microresearch/RAVEN/raven_kicad/raven_kicad.kicad_pcb

## KiCad design raven_kicad/raven_kicad.kicad_pcb (2021-03-04)

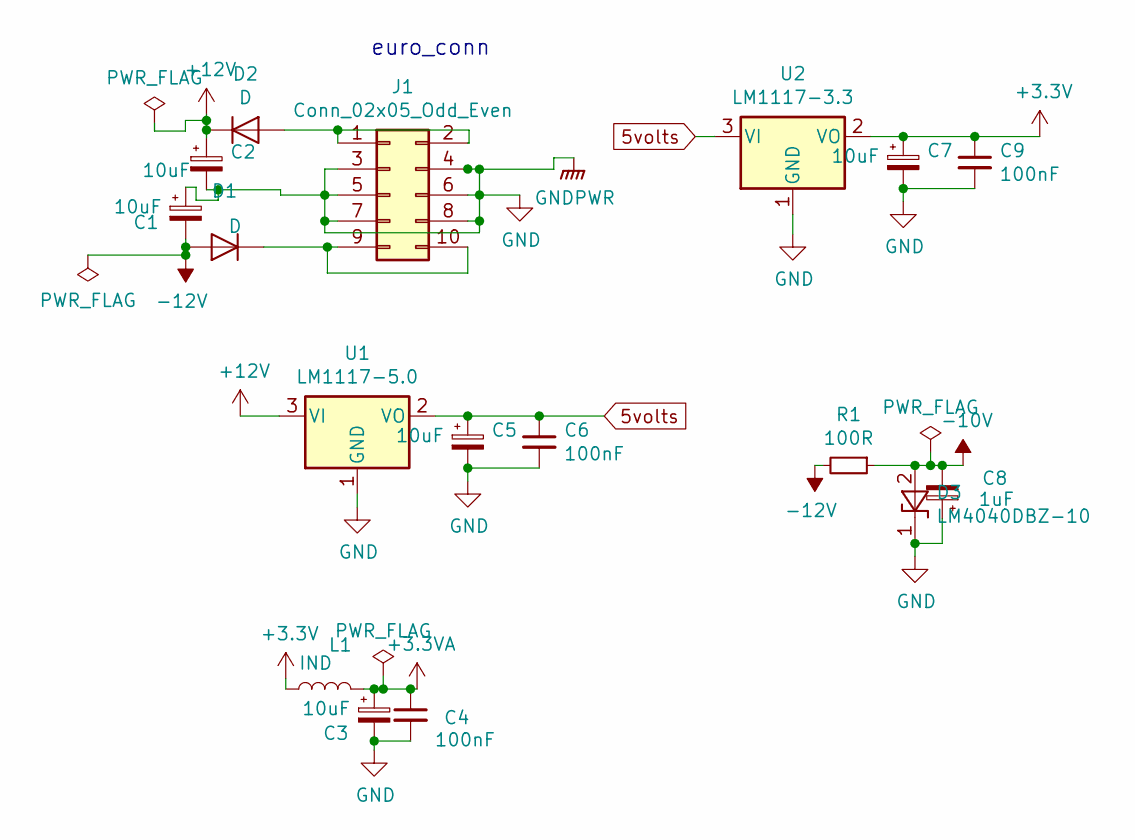
[picture p1: schematic power.sch, SEGMENTS]

Parts:
C1, C2, C3, C5, C7: 10uF; SMD-1206_Pol
C4, C6, C9: 100nF; C_0805
C8: 1uF; SMD-1206_Pol
D1, D2: D; D_SOD-123
D3: LM4040DBZ-10; SOT-23
J1: Conn_02x05_Odd_Even; Pin_Header_Straight_2x05_Pitch2.54mm
L1: IND; L_0603
R1: 100R; R_0805
U1: LM1117-5.0; TO-252-2_Rectifier
U2: LM1117-3.3; TO-252-2_Rectifier

Connections:
5volts: C5.1, C6.1, U1.2 (VO), U2.3 (VI)
+3.3VA: C3.1, C4.1, L1.2; also elsewhere on the board
+3V3: C7.1, C9.1, L1.1, U2.2 (VO); also elsewhere on the board
+12V: C2.1, D2.1 (K), U1.3 (VI); also elsewhere on the board
-10V: C8.2, D3.2 (A), R1.1; also elsewhere on the board
-12V: C1.2, D1.2 (A), R1.2; also elsewhere on the board
GND: C1.1, C2.2, C3.2, C4.2, C5.2, C6.2, C7.2, C8.1, C9.2, D3.1 (K), J1.3, J1.4, J1.5, J1.6, J1.7, J1.8, U1.1 (GND), U2.1 (GND); also elsewhere on the board
unnamed: D1.1 (K), J1.9, J1.10
unnamed: D2.2 (A), J1.1, J1.2

Notes on the sheet:
euro_conn

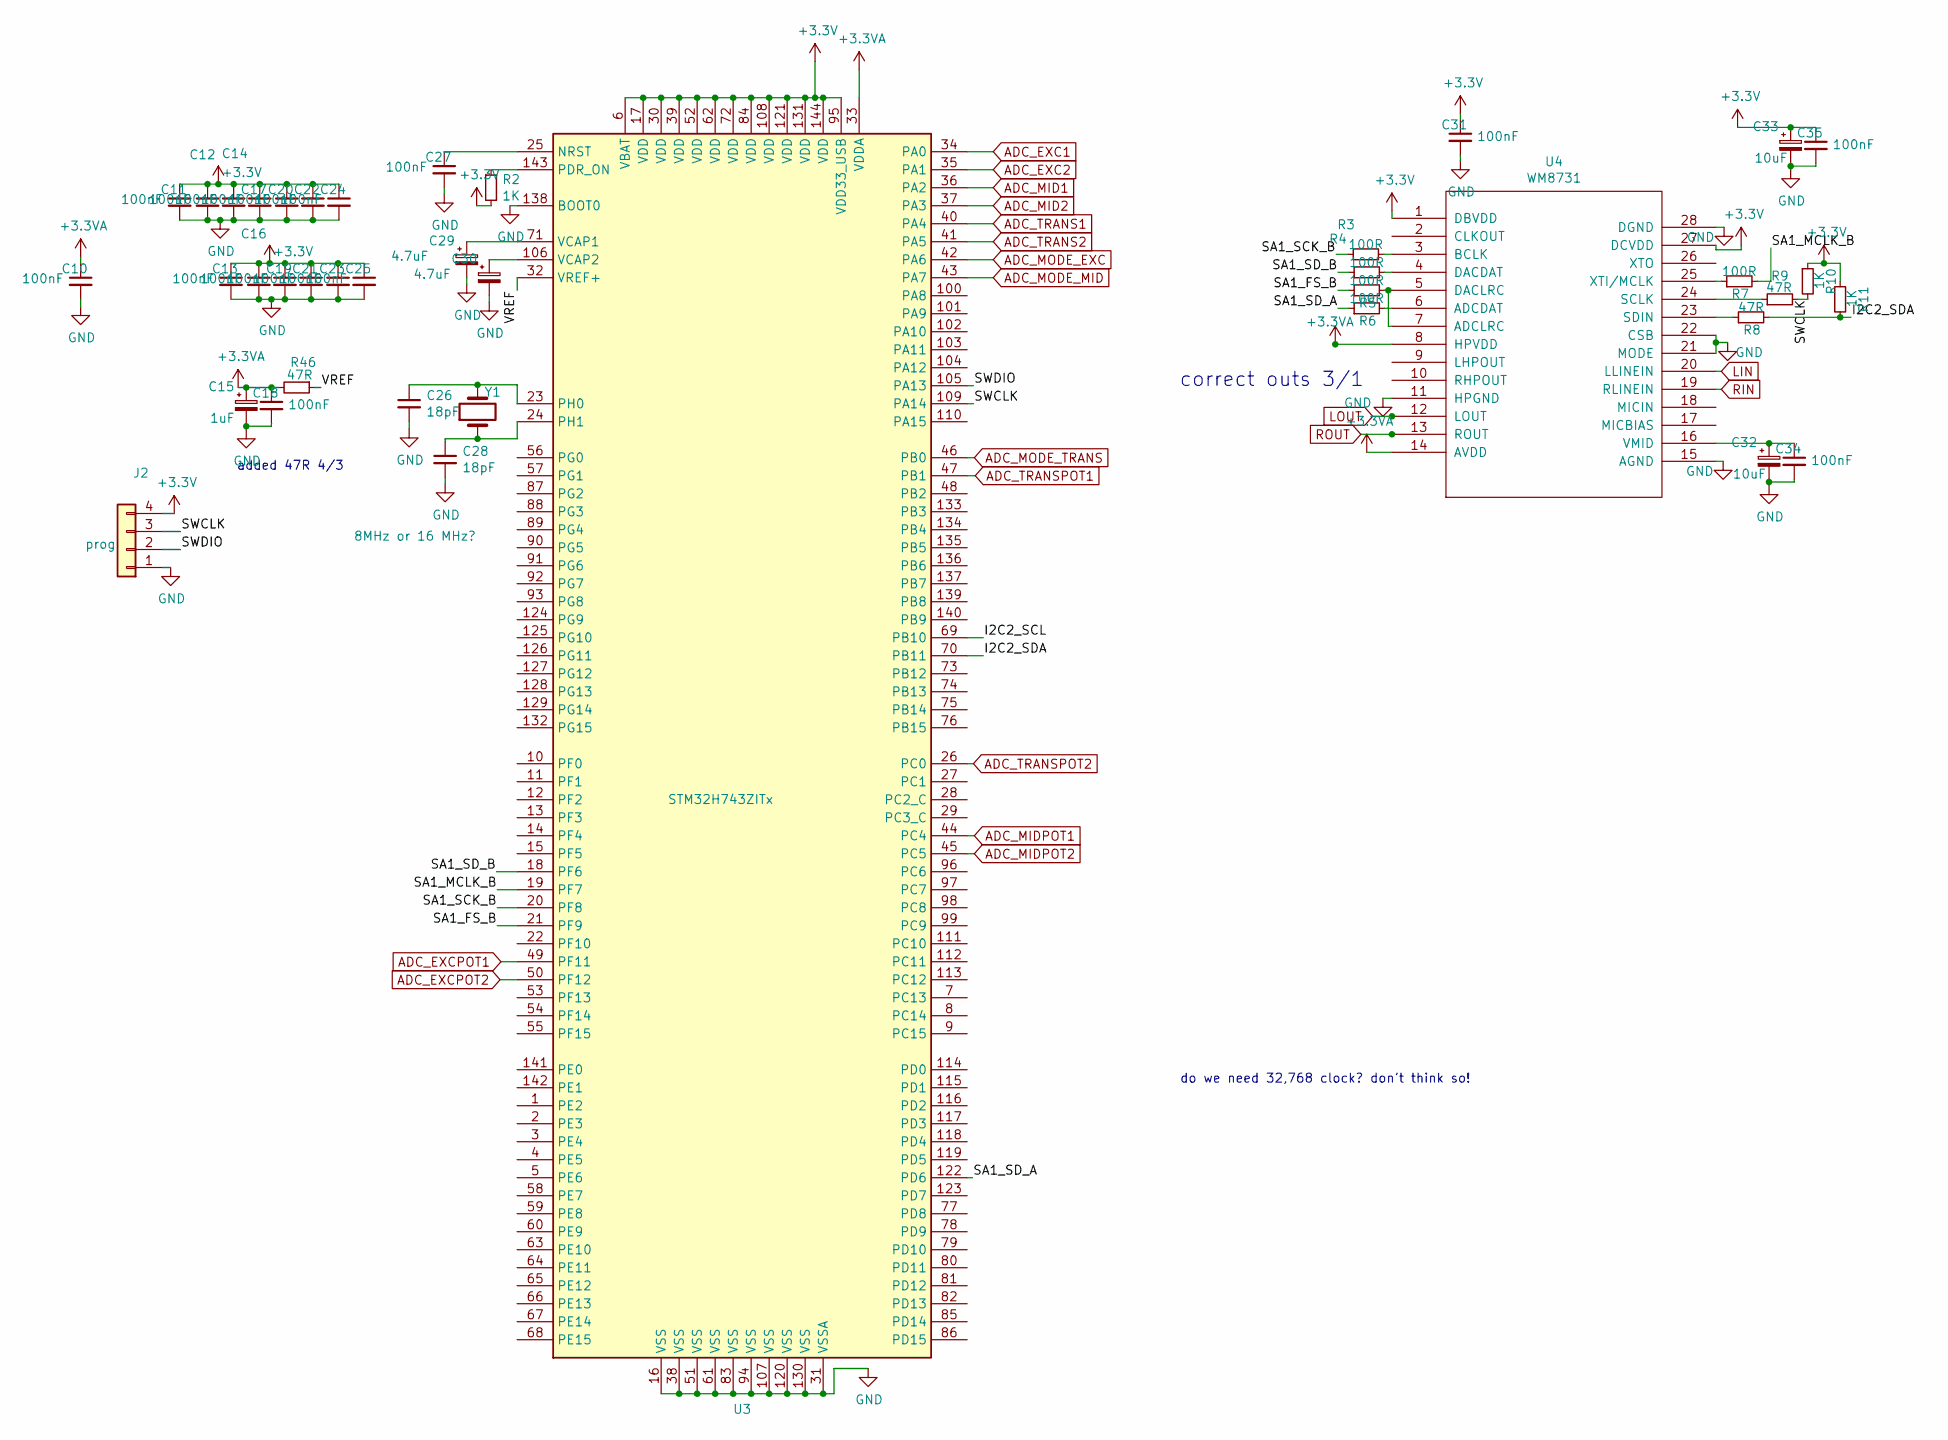
[picture p2: schematic micro.sch]

Parts:
C10, C11, C12, C13, C14, C16, C17, C18, C19, C20, C21, C22, C23, C24, C25, C27, C31, C34, C35: 100nF; C_0805
C15: 1uF; SMD-1206_Pol
C26, C28: 18pF; C_0805
C29, C30: 4.7uF; SMD-1206_Pol
C32, C33: 10uF; SMD-1206_Pol
J2: prog; Pin_Header_Straight_1x04_Pitch2.54mm
R2, R10, R11: 1K; R_0805
R3, R4, R5, R6, R7: 100R; R_0805
R8, R9, R46: 47R; R_0805
U3: STM32H743ZITx; LQFP-144_20x20mm_Pitch0.5mm
U4: WM8731; SSOP-28_5.3x10.2mm_Pitch0.65mm
Y1: 8MHz or 16 MHz?; Crystal_SMD_HC49-SD

Connections:
+3.3VA: C10.1, C15.1, C18.1, R46.2, U3.33 (VDDA), U4.8 (HPVDD), U4.14 (AVDD); also elsewhere on the board
+3V3: C11.1, C12.1, C13.1, C14.1, C16.1, C17.1, C19.1, C20.1, C21.1, C22.1, C23.1, C24.1, C25.1, C31.1, C33.1, C35.1, J2.4, R2.2, R10.1, R11.1, U3.6 (VBAT), U3.17 (VDD), U3.30 (VDD), U3.39 (VDD), U3.52 (VDD), U3.62 (VDD), U3.72 (VDD), U3.84 (VDD), U3.95 (VDD33_USB), U3.108 (VDD), U3.121 (VDD), U3.131 (VDD), U3.144 (VDD), U4.1 (DBVDD), U4.27 (DCVDD); also elsewhere on the board
/micro/I2C2_SDA: R8.2, R11.2, U3.70 (PB11)
/micro/SA1_FS_B: R5.1, U3.21 (PF9)
/micro/SA1_MCLK_B: R7.2, U3.19 (PF7)
/micro/SA1_SCK_B: R3.1, U3.20 (PF8)
/micro/SA1_SD_A: R6.1, U3.122 (PD6)
/micro/SA1_SD_B: R4.1, U3.18 (PF6)
/micro/SWCLK: J2.3, R9.2, R10.2, U3.109 (PA14)
/micro/SWDIO: J2.2, U3.105 (PA13)
/micro/VREF: R46.1, U3.32 (VREF+)
ADC_EXC1: U3.34 (PA0); also elsewhere on the board
ADC_EXC2: U3.35 (PA1); also elsewhere on the board
ADC_EXCPOT1: U3.49 (PF11); also elsewhere on the board
ADC_EXCPOT2: U3.50 (PF12); also elsewhere on the board
ADC_MID1: U3.36 (PA2); also elsewhere on the board
ADC_MID2: U3.37 (PA3); also elsewhere on the board
ADC_MIDPOT1: U3.44 (PC4); also elsewhere on the board
ADC_MIDPOT2: U3.45 (PC5); also elsewhere on the board
ADC_MODE_EXC: U3.42 (PA6); also elsewhere on the board
ADC_MODE_MID: U3.43 (PA7); also elsewhere on the board
ADC_MODE_TRANS: U3.46 (PB0); also elsewhere on the board
ADC_TRANS1: U3.40 (PA4); also elsewhere on the board
ADC_TRANS2: U3.41 (PA5); also elsewhere on the board
ADC_TRANSPOT1: U3.47 (PB1); also elsewhere on the board
ADC_TRANSPOT2: U3.26 (PC0); also elsewhere on the board
GND: C10.2, C11.2, C12.2, C13.2, C14.2, C15.2, C16.2, C17.2, C18.2, C19.2, C20.2, C21.2, C22.2, C23.2, C24.2, C25.2, C26.2, C27.2, C28.2, C29.2, C30.2, C31.2, C32.2, C33.2, C34.2, C35.2, J2.1, U3.16 (VSS), U3.31 (VSSA), U3.38 (VSS), U3.51 (VSS), U3.61 (VSS), U3.83 (VSS), U3.94 (VSS), U3.107 (VSS), U3.120 (VSS), U3.130 (VSS), U3.138 (BOOT0), U4.11 (HPGND), U4.15 (AGND), U4.21 (MODE), U4.22 (CSB), U4.28 (DGND); also elsewhere on the board
LIN: U4.20 (LLINEIN); also elsewhere on the board
LOUT: U4.12 (LOUT); also elsewhere on the board
unnamed: C26.1, U3.23 (PH0), Y1.2
unnamed: C27.1, U3.25 (NRST)
unnamed: C28.1, U3.24 (PH1), Y1.1
unnamed: C29.1, U3.71 (VCAP1)
unnamed: C30.1, U3.106 (VCAP2)
unnamed: C32.1, C34.1, U4.16 (VMID)
unnamed: R2.1, U3.143 (PDR_ON)
unnamed: R3.2, U4.3 (BCLK)
unnamed: R4.2, U4.4 (DACDAT)
unnamed: R5.2, U4.5 (DACLRC), U4.7 (ADCLRC)
unnamed: R6.2, U4.6 (ADCDAT)
unnamed: R7.1, U4.25 (XTI/MCLK)
unnamed: R8.1, U4.23 (SDIN)
unnamed: R9.1, U4.24 (SCLK)
RIN: U4.19 (RLINEIN); also elsewhere on the board
ROUT: U4.13 (ROUT); also elsewhere on the board

Notes on the sheet:
do we need 32,768 clock? don't think so!
correct outs 3/1
added 47R 4/3

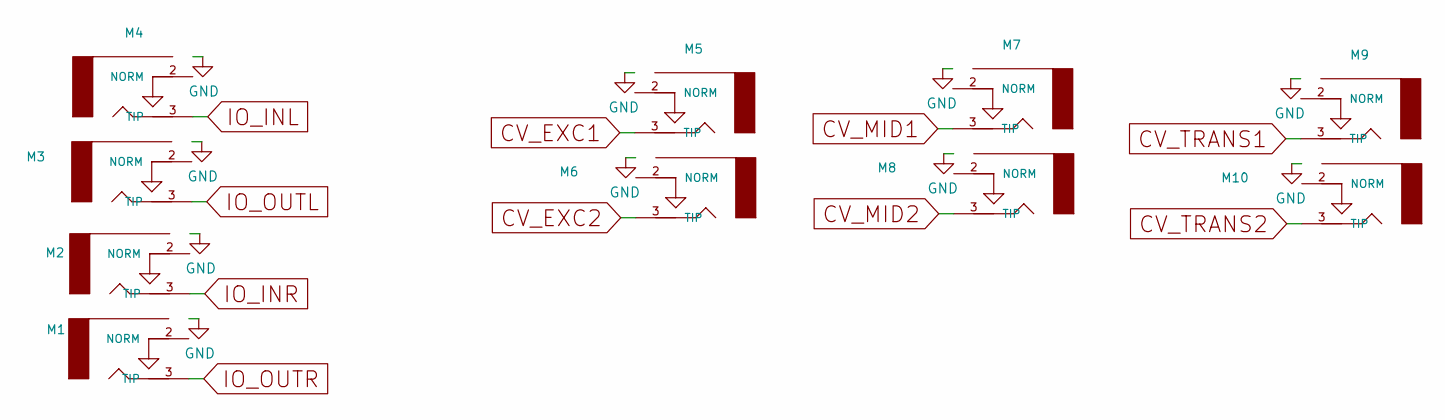
[picture p3: schematic inout.sch, SEGMENTS]

Parts:
M1, M2, M3, M4, M5, M6, M7, M8, M9, M10: AUDIO-JACKERTHENVAR; Jack_3.5mm_QingPu_WQP-PJ398SM_Vertical_CircularHoles

Connections:
CV_EXC1: M5.3 (TIP); also elsewhere on the board
CV_EXC2: M6.3 (TIP); also elsewhere on the board
CV_MID1: M7.3 (TIP); also elsewhere on the board
CV_MID2: M8.3 (TIP); also elsewhere on the board
CV_TRANS1: M9.3 (TIP); also elsewhere on the board
CV_TRANS2: M10.3 (TIP); also elsewhere on the board
GND: M1.1 (RING), M2.1 (RING), M3.1 (RING), M4.1 (RING), M5.1 (RING), M6.1 (RING), M7.1 (RING), M8.1 (RING), M9.1 (RING), M10.1 (RING); also elsewhere on the board
IO_INL: M4.3 (TIP); also elsewhere on the board
IO_INR: M2.3 (TIP); also elsewhere on the board
IO_OUTL: M3.3 (TIP); also elsewhere on the board
IO_OUTR: M1.3 (TIP); also elsewhere on the board

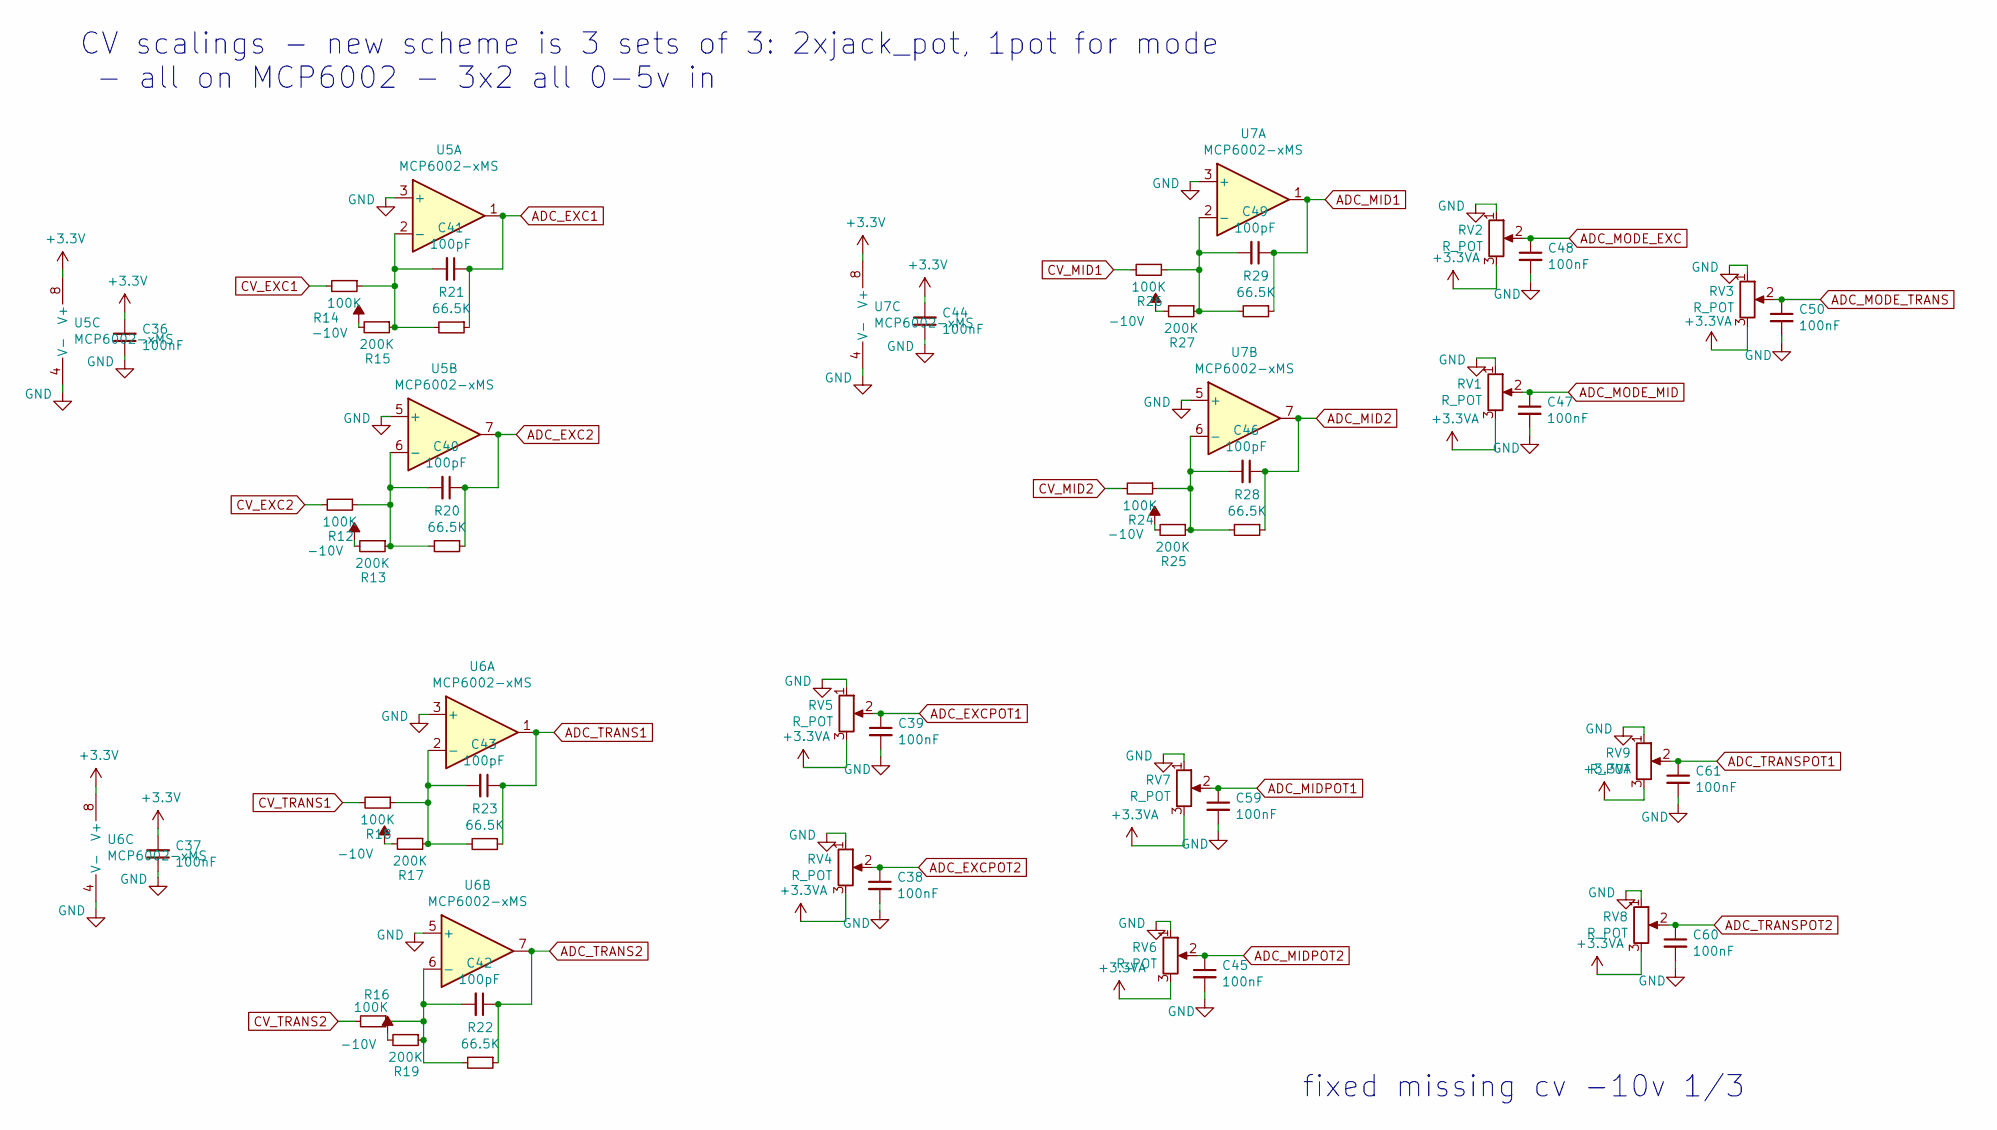
[picture p4: schematic cv.sch]

Parts:
C36, C37, C38, C39, C44, C45, C47, C48, C50, C59, C60, C61: 100nF; C_0805
C40, C41, C42, C43, C46, C49: 100pF; C_0805
R12, R14, R16, R18, R24, R26: 100K; R_0805
R13, R15, R17, R19, R25, R27: 200K; R_0805
R20, R21, R22, R23, R28, R29: 66.5K; R_0805
RV1, RV2, RV3, RV4, RV5, RV6, RV7, RV8, RV9: R_POT; Potentiometer_Alps-RK09
U5, U6, U7: MCP6002-xMS; SOIC-8-N

Connections:
+3.3VA: RV1.3, RV2.3, RV3.3, RV4.3, RV5.3, RV6.3, RV7.3, RV8.3, RV9.3; also elsewhere on the board
+3V3: C36.2, C37.2, C44.2, U5.8 (V+), U6.8 (V+), U7.8 (V+); also elsewhere on the board
-10V: R13.2, R15.2, R17.2, R19.2, R25.2, R27.2; also elsewhere on the board
ADC_EXC1: C41.1, R21.1, U5.1; also elsewhere on the board
ADC_EXC2: C40.1, R20.1, U5.7; also elsewhere on the board
ADC_EXCPOT1: C39.1, RV5.2; also elsewhere on the board
ADC_EXCPOT2: C38.1, RV4.2; also elsewhere on the board
ADC_MID1: C49.1, R29.1, U7.1; also elsewhere on the board
ADC_MID2: C46.1, R28.1, U7.7; also elsewhere on the board
ADC_MIDPOT1: C59.1, RV7.2; also elsewhere on the board
ADC_MIDPOT2: C45.1, RV6.2; also elsewhere on the board
ADC_MODE_EXC: C48.1, RV2.2; also elsewhere on the board
ADC_MODE_MID: C47.1, RV1.2; also elsewhere on the board
ADC_MODE_TRANS: C50.1, RV3.2; also elsewhere on the board
ADC_TRANS1: C43.1, R23.1, U6.1; also elsewhere on the board
ADC_TRANS2: C42.1, R22.1, U6.7; also elsewhere on the board
ADC_TRANSPOT1: C61.1, RV9.2; also elsewhere on the board
ADC_TRANSPOT2: C60.1, RV8.2; also elsewhere on the board
CV_EXC1: R14.2; also elsewhere on the board
CV_EXC2: R12.2; also elsewhere on the board
CV_MID1: R26.2; also elsewhere on the board
CV_MID2: R24.2; also elsewhere on the board
CV_TRANS1: R18.2; also elsewhere on the board
CV_TRANS2: R16.2; also elsewhere on the board
GND: C36.1, C37.1, C38.2, C39.2, C44.1, C45.2, C47.2, C48.2, C50.2, C59.2, C60.2, C61.2, RV1.1, RV2.1, RV3.1, RV4.1, RV5.1, RV6.1, RV7.1, RV8.1, RV9.1, U5.3 (+), U5.4 (V-), U5.5 (+), U6.3 (+), U6.4 (V-), U6.5 (+), U7.3 (+), U7.4 (V-), U7.5 (+); also elsewhere on the board
unnamed: C40.2, R12.1, R13.1, R20.2, U5.6 (-)
unnamed: C41.2, R14.1, R15.1, R21.2, U5.2 (-)
unnamed: C42.2, R16.1, R19.1, R22.2, U6.6 (-)
unnamed: C43.2, R17.1, R18.1, R23.2, U6.2 (-)
unnamed: C46.2, R24.1, R25.1, R28.2, U7.6 (-)
unnamed: C49.2, R26.1, R27.1, R29.2, U7.2 (-)

Notes on the sheet:
CV scalings - new scheme is 3 sets of 3: 2xjack_pot, 1pot for mode - all on MCP6002 - 3x2 all 0-5v in
fixed missing cv -10v 1/3

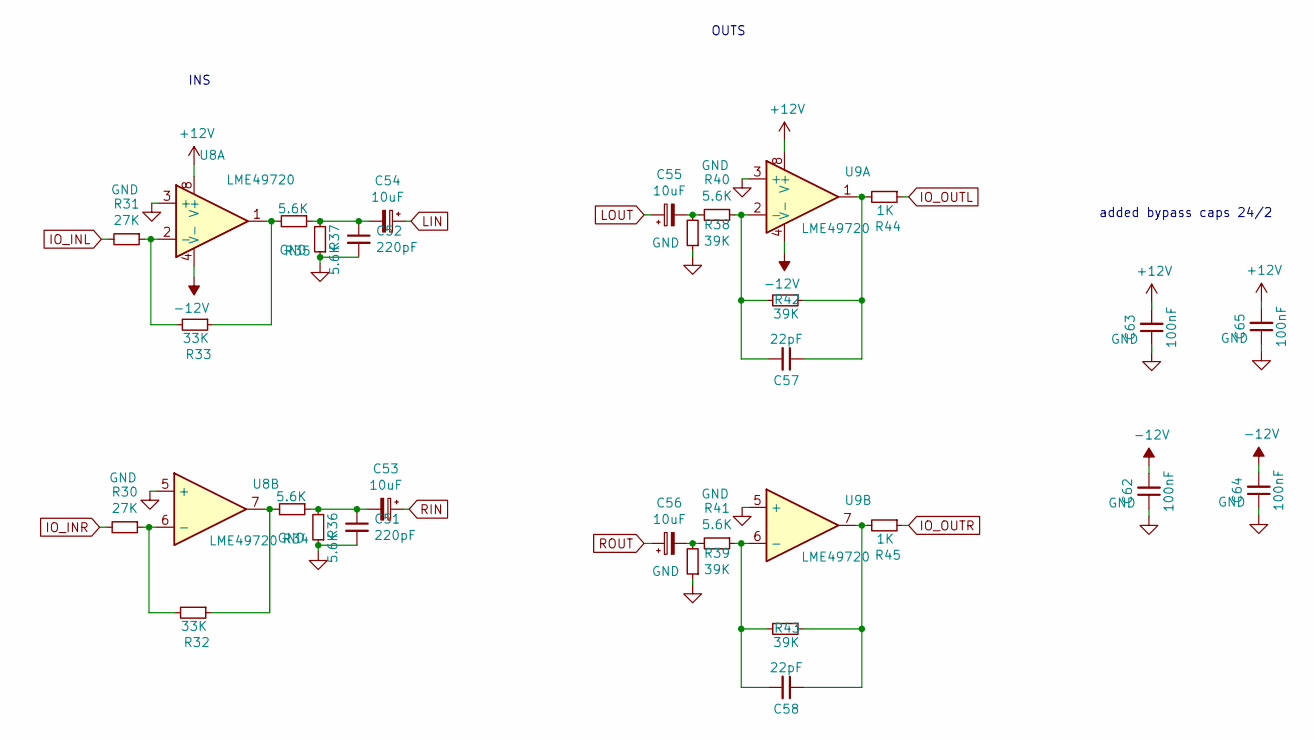
[picture p5: schematic inoutamps.sch]

Parts:
C51, C52: 220pF; C_0805
C53, C54, C55, C56: 10uF; SMD-1206_Pol
C57, C58: 22pF; C_0805
C62, C63, C64, C65: 100nF; C_0805
R30, R31: 27K; R_0805
R32, R33: 33K; R_0805
R34, R35, R36, R37, R40, R41: 5.6K; R_0805
R38, R39, R42, R43: 39K; R_0805
R44, R45: 1K; R_0805
U8, U9: LME49720; SOIC-8-N

Connections:
+12V: C63.2, C65.2, U8.8 (V+), U9.8 (V+); also elsewhere on the board
-12V: C62.2, C64.2, U8.4 (V-), U9.4 (V-); also elsewhere on the board
GND: C51.2, C52.2, C62.1, C63.1, C64.1, C65.1, R36.1, R37.1, R38.1, R39.1, U8.3 (+), U8.5 (+), U9.3 (+), U9.5 (+); also elsewhere on the board
IO_INL: R31.2; also elsewhere on the board
IO_INR: R30.2; also elsewhere on the board
IO_OUTL: R44.1; also elsewhere on the board
IO_OUTR: R45.1; also elsewhere on the board
LIN: C54.1; also elsewhere on the board
LOUT: C55.1; also elsewhere on the board
unnamed: C51.1, C53.2, R34.1, R36.2
unnamed: C52.1, C54.2, R35.1, R37.2
unnamed: C55.2, R38.2, R40.2
unnamed: C56.2, R39.2, R41.2
unnamed: C57.1, R42.1, R44.2, U9.1
unnamed: C57.2, R40.1, R42.2, U9.2 (-)
unnamed: C58.1, R43.1, R45.2, U9.7
unnamed: C58.2, R41.1, R43.2, U9.6 (-)
unnamed: R30.1, R32.2, U8.6 (-)
unnamed: R31.1, R33.2, U8.2 (-)
unnamed: R32.1, R34.2, U8.7
unnamed: R33.1, R35.2, U8.1
RIN: C53.1; also elsewhere on the board
ROUT: C56.1; also elsewhere on the board

Notes on the sheet:
INS
OUTS
added bypass caps 24/2

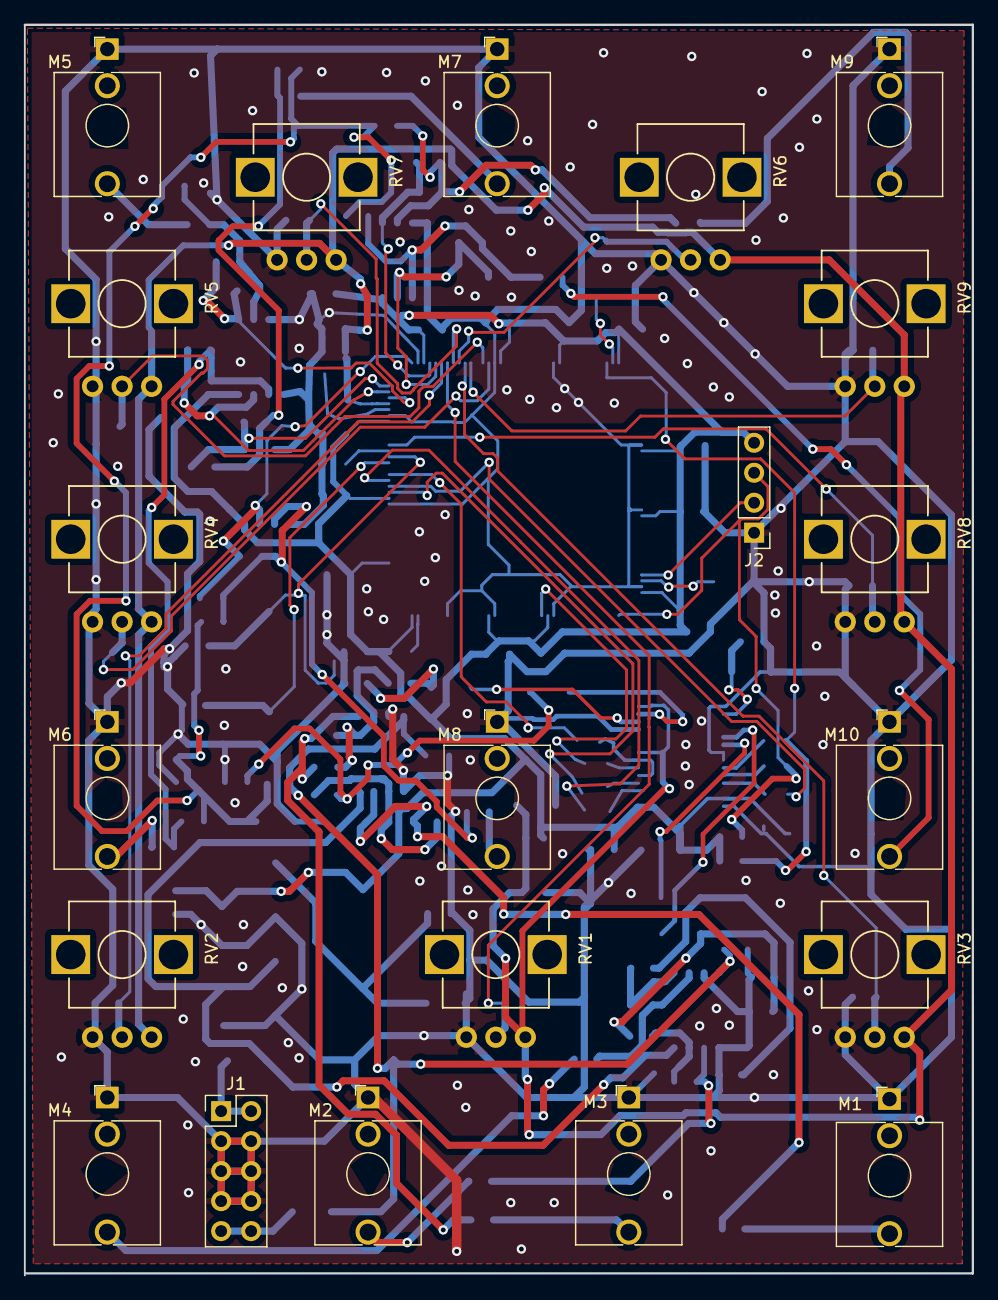
[picture p6: board raven_kicad.kicad_pcb from above]

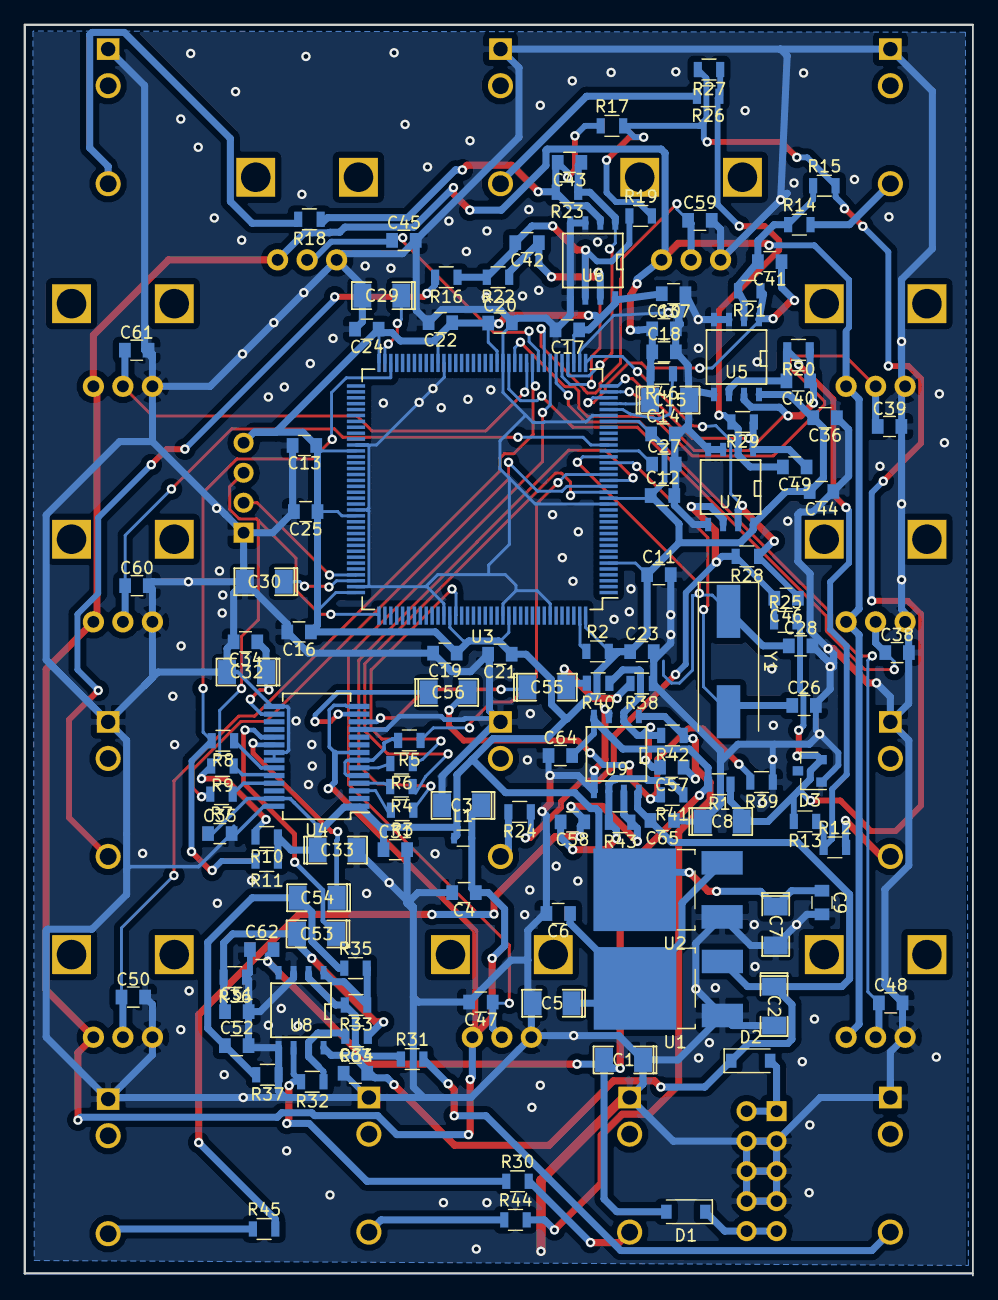
[picture p7: board raven_kicad.kicad_pcb from below]

Board: 2 copper layers, 80.3 x 105.9 mm, 146 parts (125 on the bottom side), 79 nets.
