microresearch/RAVEN/STM32H743/src/wavetables.h

// drawn wavetable from kahrs.pdf at 32k 200 Hz
 
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
7, 0.094530, 0.081993, 0.069575, 0.057277, 0.045099, 0.033041, 0.021102, 0.009283, -0.002417, -0.013999, -0.025461, -0.036806, -0.048033, -0.059143, -0.070136, -0.081014, -0.091776, -0.102423, -0.112957, -0.123377, -0.133685, -0.143880, -0.153965, -0.163940, -0.173805, -0.183561, -0.193210, -0.202752, -0.212188, -0.221519, -0.230745, -0.239868, -0.248889, -0.257807, -0.266626, -0.275344, -0.283964, -0.292486, -0.300910, -0.309239, -0.317472, -0.325611, -0.333657, -0.341611, -0.349472, -0.357244, -0.364925, -0.372518, -0.380023, -0.387441, -0.394773, -0.402019, -0.999997};

// also would be nice to have slower pulse - larger pause between pulses which we could maybe do in wavetable stuff 

// this one normalized in audacity but also speeded up so looks a bit rough...

const float plaguetable_simplesir_002[493]  __attribute__ ((section (".flash"))) ={-0.471802, -0.471741, -0.471619, -0.471558, -0.471466, -0.471313, -0.471283, -0.471130, -0.471039, -0.470917, -0.470795, -0.470673, -0.470581, -0.470398, -0.470276, -0.470154, -0.469971, -0.469849, -0.469696, -0.469513, -0.469360, -0.469147, -0.468994, -0.468842, -0.468536, -0.468475, -0.468109, -0.468018, -0.467743, -0.467438, -0.467316, -0.466919, -0.466797, -0.466461, -0.466125, -0.465942, -0.465515, -0.465332, -0.464844, -0.464600, -0.464172, -0.463898, -0.463440, -0.463165, -0.462585, -0.462341, -0.461761, -0.461395, -0.460876, -0.460419, -0.459869, -0.459381, -0.458801, -0.458191, -0.457764, -0.456940, -0.456451, -0.455750, -0.455048, -0.454437, -0.453583, -0.452881, -0.452087, -0.451294, -0.450378, -0.449646, -0.448486, -0.447876, -0.446564, -0.445831, -0.444611, -0.443604, -0.442413, -0.441345, -0.440063, -0.438812, -0.437622, -0.436066, -0.434906, -0.433289, -0.431915, -0.430267, -0.428772, -0.427002, -0.425385, -0.423553, -0.421753, -0.419769, -0.417877, -0.415771, -0.413666, -0.411530, -0.409180, -0.406952, -0.404388, -0.401978, -0.399353, -0.396698, -0.393860, -0.391144, -0.387909, -0.385132, -0.381775, -0.378571, -0.375214, -0.371643, -0.368103, -0.364288, -0.360504, -0.356506, -0.352417, -0.348145, -0.343811, -0.339203, -0.334686, -0.329803, -0.324829, -0.319824, -0.314423, -0.309113, -0.303467, -0.297729, -0.291840, -0.285614, -0.279541, -0.272827, -0.266449, -0.259430, -0.252472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

// 96000 in audacity
const float crowtable_slower[283]  __attribute__ ((section (".flash"))) ={-0.264069, -0.214813, -0.075928, 0.079102, 0.227264, 0.363129, 0.475250, 0.570251, 0.656921, 0.690613, 0.610107, 0.452240, 0.351227, 0.375122, 0.437897, 0.427887, 0.357727, 0.313049, 0.302124, 0.259338, 0.173584, 0.116852, 0.132568, 0.169739, 0.157806, 0.095215, 0.040466, 0.054413, 0.148926, 0.262115, 0.279449, 0.149475, -0.025208, -0.074005, 0.040771, 0.176270, 0.202698, 0.162476, 0.183044, 0.285461, 0.372925, 0.382507, 0.359558, 0.371063, 0.415619, 0.445129, 0.428131, 0.373138, 0.314880, 0.290344, 0.300751, 0.293213, 0.221130, 0.123932, 0.095825, 0.163635, 0.235718, 0.215637, 0.126373, 0.078918, 0.140747, 0.272003, 0.386292, 0.433899, 0.419861, 0.381287, 0.356812, 0.364136, 0.381439, 0.359253, 0.269470, 0.147552, 0.077148, 0.108978, 0.196198, 0.236664, 0.195679, 0.147552, 0.167542, 0.208954, 0.164948, 0.035248, -0.053680, -0.019226, 0.071747, 0.119781, 0.130981, 0.162933, 0.194336, 0.165161, 0.101990, 0.084778, 0.094147, 0.020569, -0.144623, -0.257141, -0.216309, -0.103516, -0.042480, -0.028900, 0.001465, 0.013397, -0.073578, -0.220367, -0.307373, -0.328308, -0.402618, -0.561615, -0.671906, -0.637360, -0.557220, -0.586975, -0.722168, -0.832794, -0.857330, -0.852325, -0.867706, -0.885040, -0.882294, -0.878571, -0.880676, -0.858887, -0.803162, -0.749420, -0.724609, -0.698822, -0.632141, -0.531616, -0.439087, -0.376282, -0.329803, -0.279419, -0.225647, -0.192291, -0.199860, -0.236206, -0.260193, -0.255524, -0.248108, -0.255005, -0.248047, -0.216370, -0.224640, -0.322296, -0.424255, -0.385986, -0.215576, -0.086578, -0.098724, -0.145020, -0.091705, 0.020508, 0.077545, 0.090302, 0.143219, 0.204315, 0.164246, 0.051361, 0.020599, 0.105011, 0.159546, 0.109558, 0.078888, 0.168182, 0.268311, 0.245758, 0.169525, 0.175934, 0.204742, 0.095398, -0.099365, -0.131500, 0.072937, 0.279877, 0.269684, 0.123444, 0.065033, 0.151886, 0.261383, 0.308807, 0.333923, 0.404572, 0.540741, 0.718445, 0.870361, 0.909027, 0.822052, 0.709930, 0.660858, 0.636047, 0.562531, 0.480133, 0.476227, 0.520508, 0.502869, 0.429596, 0.420532, 0.503632, 0.560608, 0.538208, 0.545868, 0.661316, 0.769684, 0.733215, 0.606232, 0.545227, 0.567596, 0.559021, 0.473938, 0.381195, 0.311890, 0.218872, 0.102539, 0.044678, 0.074524, 0.108673, 0.079285, 0.014740, -0.051270, -0.154938, -0.312683, -0.447113, -0.478790, -0.425385, -0.336426, -0.200623, -0.012939, 0.132416, 0.126740, -0.002716, -0.138306, -0.241974, -0.373352, -0.535156, -0.630157, -0.601715, -0.522675, -0.487610, -0.488037, -0.456207, -0.379028, -0.314514, -0.323029, -0.408722, -0.511627, -0.539185, -0.456390, -0.345306, -0.317017, -0.350189, -0.309631, -0.157440, -0.037506, -0.067627, -0.145386, -0.094635, 0.064423, 0.143341, 0.068604, -0.033264, -0.059601, -0.076294, -0.157959, -0.225433, -0.176208, -0.082672, -0.109985, -0.260742, -0.360565, -0.310760, -0.231079, -0.286316, -0.460144, -0.588745, -0.575531, -0.493347, -0.471558, -0.535767, -0.587677, -0.519745, -0.331421, -0.129639, -0.015930};

// sine
const float ourtable[512] __attribute__ ((section (".flash")))={0.000000, 0.012296, 0.024589, 0.036879, 0.049164, 0.061441, 0.073708, 0.085965, 0.098208, 0.110437, 0.122649, 0.134842, 0.147016, 0.159166, 0.171293, 0.183394, 0.195467, 0.207511, 0.219523, 0.231502, 0.243446, 0.255353, 0.267222, 0.279050, 0.290836, 0.302578, 0.314275, 0.325923, 0.337523, 0.349071, 0.360567, 0.372008, 0.383393, 0.394720, 0.405988, 0.417194, 0.428337, 0.439415, 0.450426, 0.461370, 0.472244, 0.483046, 0.493776, 0.504430, 0.515009, 0.525509, 0.535931, 0.546271, 0.556528, 0.566702, 0.576789, 0.586790, 0.596702, 0.606524, 0.616253, 0.625890, 0.635432, 0.644878, 0.654227, 0.663477, 0.672626, 0.681674, 0.690618, 0.699458, 0.708193, 0.716820, 0.725339, 0.733748, 0.742047, 0.750233, 0.758306, 0.766264, 0.774106, 0.781832, 0.789439, 0.796926, 0.804293, 0.811539, 0.818662, 0.825661, 0.832535, 0.839284, 0.845905, 0.852399, 0.858764, 0.864999, 0.871103, 0.877076, 0.882916, 0.888622, 0.894194, 0.899631, 0.904932, 0.910096, 0.915122, 0.920010, 0.924759, 0.929369, 0.933837, 0.938165, 0.942350, 0.946394, 0.950294, 0.954050, 0.957662, 0.961130, 0.964452, 0.967628, 0.970658, 0.973541, 0.976278, 0.978866, 0.981306, 0.983599, 0.985742, 0.987736, 0.989581, 0.991277, 0.992822, 0.994218, 0.995463, 0.996558, 0.997502, 0.998295, 0.998937, 0.999428, 0.999768, 0.999958, 0.999995, 0.999882, 0.999617, 0.999202, 0.998635, 0.997917, 0.997049, 0.996029, 0.994859, 0.993539, 0.992068, 0.990448, 0.988678, 0.986758, 0.984689, 0.9824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
