microresearch/RAVEN/software/crow_lpc_coeffs.h

// how these were generated? with unianal, own software or praat
// matches mysinglecrow_sc_coeffs32
// but must somehow be lpcforlap - but without pre_emph!

const float own_crow_coeffs[7480] __attribute__ ((section (".flash")))={-1.050031,0.263930,-0.215297,0.027258,-0.114692,0.053116,0.145829,-0.046231,0.115907,-0.065464, 0.013260,-1.116353,0.252360,-0.031994,0.053505,0.038896,-0.207848,0.220381,-0.042472,0.060497,0.057752, 0.015003,-1.312753,0.144452,0.191185,0.113925,-0.036619,0.004105,-0.009789,-0.002722,-0.127017,0.128554, 0.009817,-1.227988,0.230866,0.091013,0.033775,-0.050923,0.040901,0.060420,0.010114,-0.004646,-0.024065, 0.018599,-0.937160,-0.000287,0.014027,0.158481,-0.027768,-0.014813,-0.102732,-0.004634,0.086992,0.031836, 0.020314,-1.025010,0.032988,0.022435,0.159760,-0.036840,-0.022714,-0.041302,-0.064299,0.041598,0.004481, 0.030559,-1.057514,-0.023028,0.085562,0.032447,0.010548,0.045946,-0.022271,-0.038853,-0.030371,0.028727, 0.036397,-1.101977,0.045676,0.026794,-0.043416,0.125145,-0.035203,0.064541,-0.053380,0.064437,-0.060587, 0.030530,-1.015929,0.074721,-0.089303,-0.023700,0.000990,0.007902,0.067356,-0.078237,0.038572,0.052882, 0.029202,-1.069667,0.109327,0.000688,-0.047227,-0.024026,-0.067414,0.101729,-0.104948,0.102950,0.031670, 0.028598,-1.027090,0.003816,0.036374,-0.065728,0.074490,-0.109205,0.162207,-0.118852,0.061673,0.013572, 0.027305,-0.973862,-0.054752,0.048514,0.012181,0.001988,-0.019604,-0.041869,0.037848,-0.017792,0.040899, 0.040179,-1.039647,-0.000385,0.048428,0.050610,0.003340,-0.047057,0.006350,-0.027986,0.028560,0.013374, 0.037380,-0.990931,0.036369,-0.055906,0.143204,0.023182,-0.029877,-0.083752,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
