microresearch/RAVEN/STM32H743/src/filtertable.h

// for EMS2000 frequencies - but these were for 32k samplerate so we need to re-calculate

/*
const float fb__140_32000[]={1.0, -0.02827939735734698, 0.0095929744675562478, -0.016316775883298176, 0.023006488242404699};
const float fb__185_32000[]={0.25, -0.039365101370256728, 0.0064138690517188124, -0.033416050650801672, 0.0054461905379422637};
const float fb__270_32000[]={0.25, -0.057405403285554102, 0.0093466301408474672, -0.048736384556789927, 0.0079388832610738369};
const float fb__367_32000[]={0.25, -0.07795454319389078, 0.012682378174050157, -0.066192755861286437, 0.01077632987173216};
const float fb__444_32000[]={0.25, -0.094236629898622026, 0.015321870747048494, -0.080028730133604134, 0.013023431221036774};
const float fb__539_32000[]={0.25, -0.11428660436946862, 0.018567946801589463, -0.097072311224966887, 0.015789517584910095};
const float fb__653_32000[]={0.25, -0.1382882644230701, 0.022447848685485217, -0.11748403294060142, 0.019099861524316974};
const float fb__791_32000[]={0.25, -0.16725350153137555, 0.027121821093174181, -0.14213102645951653, 0.023094469638971549};
const float fb__958_32000[]={0.25, -0.20216714980134362, 0.032744179395433504, -0.17186196419862124, 0.027910744162963241};
const float fb__1161_32000[]={0.25, -0.24438952714724374, 0.039527777322790114, -0.20785260208461731, 0.033740362436566529};
const float fb__1406_32000[]={0.25, -0.29500629758978919, 0.04763915211053027, -0.25105622934481459, 0.04074204663687564};
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



const float* filter_bank_table[] = {
fb__140_48000,
fb__185_48000,
fb__270_48000,
fb__367_48000,
fb__444_48000,
fb__539_48000,
fb__653_48000,
fb__791_48000,
fb__958_48000,
fb__1161_48000,
fb__1406_48000,
fb__1703_48000,
fb__2064_48000,
fb__2700_48000,
fb__4000_48000,
fb__5388_48000
};
