microresearch/RAVEN/STM32H743/src/sample_rate_converter.h

// re-working as c only

// Copyright 2015 Olivier Gillet.
//
// Author: Olivier Gillet (ol.gillet@gmail.com)
//
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
// See http://creativecommons.org/licenses/MIT/ for more information.
//
// -----------------------------------------------------------------------------
//
// Sample rate converter.

#include <algorithm>

/*
  float tmp_[2][kMaxFilterBankBlockSize];

  mid_src_down_.Process(in, tmp_[0], size);
  low_src_down_.Process(tmp_[0], tmp_[1], size / kMidFactor);

*/



namespace warps {

enum SampleRateConversionDirection {
  SRC_UP,
  SRC_DOWN
};

template <SampleRateConversionDirection direction, int32_t ratio, int32_t length>
struct SRC_FIR { };

}

#include "warps/dsp/sample_rate_conversion_filters.h"

namespace warps {

template<int32_t N>
struct FilterState {
 public:
  enum {
    n = N
  };
  inline void Push(float value) {
    tail.Push(head);
    head = value;
  }

  template<int32_t i> inline float Read() const {
    return i == 0 ? head : tail.template Read<i - 1>();
  }

  inline void Load(const float* x_state) {
    head = x_state[0];
    tail.Load(x_state + 1);
  }

  inline void Save(float* x_state) {
    x_state[0] = head;
    tail.Save(x_state + 1);
  }

 private:  
  float head;
  FilterState<N-1> tail;
}; // filterstate

 
template<>
class FilterState<1> {
 public:
  enum {
    n = 1
  };
  inline void Push(float value) {
    head = value;
  }

  template<int32_t i> inline float Read() const {
    return head;
  }

  inline void Load(const float* x_state) {
    head = x_state[0];
  }

  inline void Save(float* x_state) {
    x_state[0] = head;
  }
 private:
  float head;
 };

////

template<int32_t N, int32_t x_stride, int32_t h_stride, int32_t mirror = 0, int32_t i = 0, int32_t h_offset = 0>
struct Accumulator {
  enum {
    h_index = mirror != 0 && h_offset + i * h_stride >= mirror / 2 ?
        mirror - 1 - i * h_stride - h_offset : h_offset + i * h_stride
  };
  
  template<typename IR>
  inline float operator()(const float* x, const IR& h) const {
    Accumulator<N - 1, x_stride, h_stride, mirror, i + 1, h_offset> a;
    return x[i * x_stride] * h.template Read<h_index>() + a(x, h);
  }
  
  template<int32_t NN, typename IR>
  inline float operator()(const FilterState<NN>& x, const IR& h) const {
    Accumulator<N - 1, x_stride, h_stride, mirror, i + 1, h_offset> a;
    return x.template Read<i * x_stride>() * h.template Read<h_index>() + a(x, h);
  }
};
////////

template<int32_t x_stride, int32_t h_stride, int32_t mirror, int32_t i, int32_t h_offset>
struct Accumulator<0, x_stride, h_stride, mirror, i, h_offset> {
  template<typename IR>
  inline float operator()(const float* x, const IR& h) const {
    return 0.0f;
  }

  template<int32_t NN, typename IR>
  inline float operator()(const FilterState<NN>& x, const IR& h) const {
    return 0.0f;
  }
};

////
 
template<int32_t K, int32_t mirror = 0, int32_t remaining = K>
struct PolyphaseStage {
  template<typename T, typename IR>
  inline void operator()(float* &y, const T& x, const IR& h) const {
    Accumulator<T::n, 1, K, mirror, 0, K - remaining> a;
    *y++ = a(x, h);
    PolyphaseStage<K, mirror, remaining - 1> p;
    p(y, x, h);
  }
};

/////
 
template<int32_t K, int32_t mirror>
struct PolyphaseStage<K, mirror, 0> {
  template<typename T, typename IR>
  inline void operator()(float* &y, const T& x, const IR& h) const { }
};

/////
 
template<
    SampleRateConversionDirection direction,
    int32_t ratio,
    int32_t filter_size>
class SampleRateConverter { };

/// SRC_UP
 
template<int32_t ratio, int32_t filter_size>
class SampleRateConverter<SRC_UP, ratio, filter_size> {
 private:
  enum {
    N = filter_size / ratio,
    K = ratio
  };

  ///
  
 public:
  SampleRateConverter() { }
  ~SampleRateConverter() { }

  inline void Init() {
    std::fill(&x_[0], &x_[N], 0);
  };

  inline int32_t delay() const { return filter_size / ratio / 2; }

  inline void Process(const float* in, float* out, size_t input_size) {
    SRC_FIR<SRC_UP, ratio, filter_size> ir;
    FilterState<N> x;
    x.Load(x_);
    while (input_size--) {
      x.Push(*in++);
      PolyphaseStage<K, filter_size> polyphase_stage;
      polyphase_stage(out, x, ir);
    }
    x.Save(x_);
  }
  
 private:
  float x_[N];

  DISALLOW_COPY_AND_ASSIGN(SampleRateConverter);
 };

/// SRC_DOWN
//   SampleRateConverter<SRC_DOWN, 3, 36> mid_src_down_;

/*
// Generated with:
// 1 * scipy.signal.remez(36, [0, 0.050000 / 3, 0.5 / 3, 0.5], [1, 0])
template<>
struct SRC_FIR<SRC_DOWN, 3, 36> {
  template<int32_t i> inline float Read() const {
    const float h[] = {
       7.037258286e-05,  3.133045342e-04,  8.387856444e-04,  1.615835717e-03,
       2.304029008e-03,  2.174858731e-03,  2.859951820e-04, -4.011553507e-03,
      -1.034565505e-02, -1.671165010e-02, -1.942380877e-02, -1.394603230e-02,
       3.461304086e-03,  3.381848881e-02,  7.408431457e-02,  1.171808754e-01,
       1.536691742e-01,  1.746213612e-01,
    };
    return h[i];
  }
};
*/
 
template<int32_t ratio, int32_t filter_size>
class SampleRateConverter<SRC_DOWN, ratio, filter_size> {
 private:
  enum {
    N = filter_size,
    K = ratio
  };
 
 public:
  SampleRateConverter() { }
  ~SampleRateConverter() { }

  inline void Init() {
    std::fill(&x_[0], &x_[2 * N], 0);
    x_ptr_ = &x_[N - 1];
  };

  inline int32_t delay() const { return filter_size / 2; }

  inline void Process(const float* in, float* out, size_t input_size) {
    // When downsampling, the number of input samples must be a multiple
    // of the downsampling ratio.
    if ((input_size % ratio) != 0) {
      return;
    }

    SRC_FIR<SRC_DOWN, ratio, filter_size> ir;
    if (input_size >= 8 * filter_size) {
      std::copy(&in[0], &in[N], &x_[N - 1]);
      
      // Generate the samples which require access to the history buffer.
      for (int32_t i = 0; i < N; i += ratio) {
        Accumulator<N, -1, 1, filter_size> accumulator;
        *out++ = accumulator(&x_[N - 1 + i], ir);
        in += ratio;
        input_size -= ratio;
      }
        
      // From now on, all the samples we need to access are located inside
      // the input buffer passed as an argument, and since the filter
      // is small, we can unroll the summation loop.
      if ((input_size / ratio) & 1) {
        while (input_size) {
          Accumulator<N, -1, 1, filter_size> accumulator;
          *out++ = accumulator(in, ir);
          input_size -= ratio;
          in += ratio;
        }
      } else {
        while (input_size) {
          Accumulator<N, -1, 1, filter_size> accumulator;
          *out++ = accumulator(in, ir);
          *out++ = accumulator(in + ratio, ir);
          input_size -= 2 * ratio;
          in += 2 * ratio;
        }
      }

      // Copy last input samples to history buffer.
      std::copy(&in[-N + 1], &in[0], &x_[0]);
    } else {
      // Variant which uses a circular buffer to store history.
      while (input_size) {
        for (int32_t i = 0; i < ratio; ++i) {
          x_ptr_[0] = x_ptr_[N] = *in++;
          --x_ptr_;
          if (x_ptr_ < x_) {
            x_ptr_ += N;
          }
        }
        input_size -= ratio;

        Accumulator<N, 1, 1, filter_size> accumulator;
        *out++ = accumulator(&x_ptr_[1], ir);
      }
    }
  }
 
 private:
  float x_[2 * N];
  float* x_ptr_;

  DISALLOW_COPY_AND_ASSIGN(SampleRateConverter);
};

}  // namespace warps

#endif  // WARPS_DSP_SAMPLE_RATE_CONVERTER_H_
