microresearch/RAVEN/(commit log)

2021-01-11 srong i2c
2021-01-12 test spi code for h7
2021-02-01 slow porgress with H7 / nucleo
    [st.cfg]
2021-02-02 SAI audio and STM32H743 finally working...
2021-02-03 vocoder works a bit, updated filters for 48k
